versusentropy/wavefolder/panel/.svg2shenzhen-cache/images/B.Cu_g1745.png

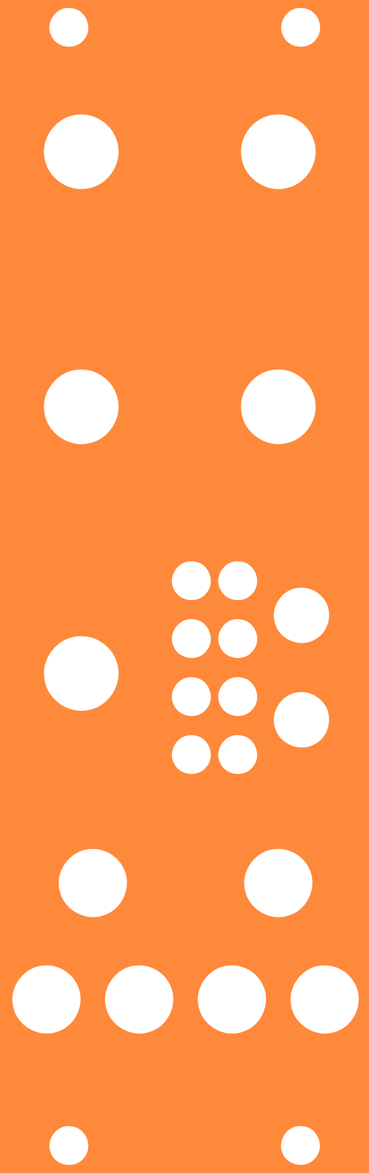
panel/.svg2shenzhen-cache/images/B.Cu_g1745.png
