versusentropy/wavefolder/panel/.svg2shenzhen-cache/images/B.Mask_g1747.png

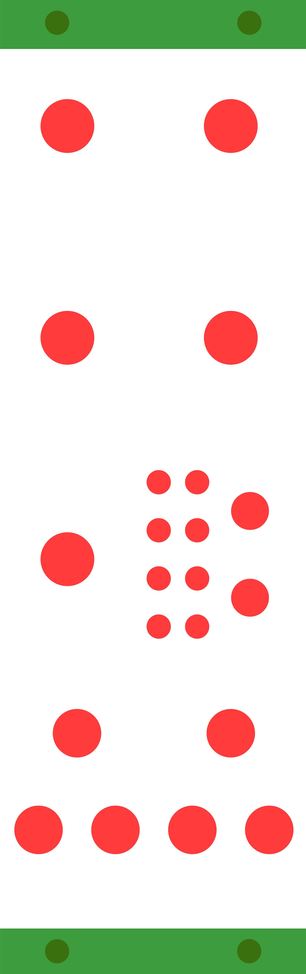
panel/.svg2shenzhen-cache/images/B.Mask_g1747.png
