versusentropy/wavefolder/panel/.svg2shenzhen-cache/images/F.Cu_g1751.png

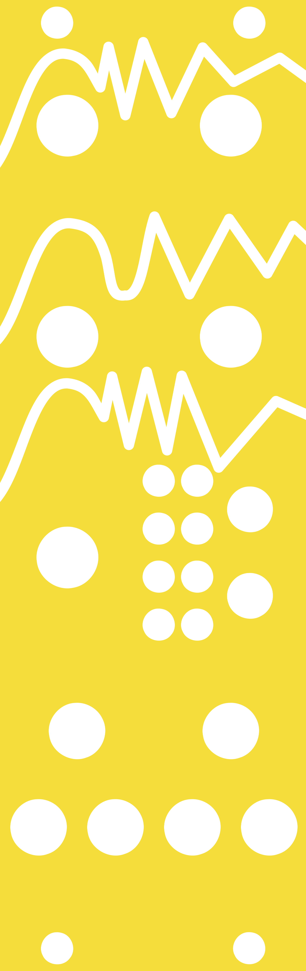
panel/.svg2shenzhen-cache/images/F.Cu_g1751.png
