versusentropy/wavefolder/panel/.svg2shenzhen-cache/images/F.SilkS_g1755.png

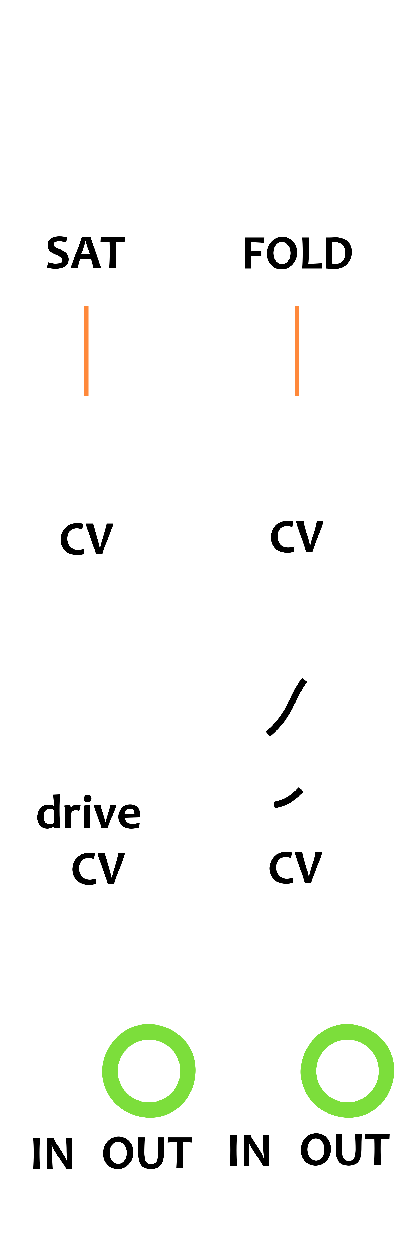
panel/.svg2shenzhen-cache/images/F.SilkS_g1755.png
