versusentropy/wavefolder/wavefolder.kicad_pcb

## KiCad design wavefolder.kicad_pcb (2022-10-06)

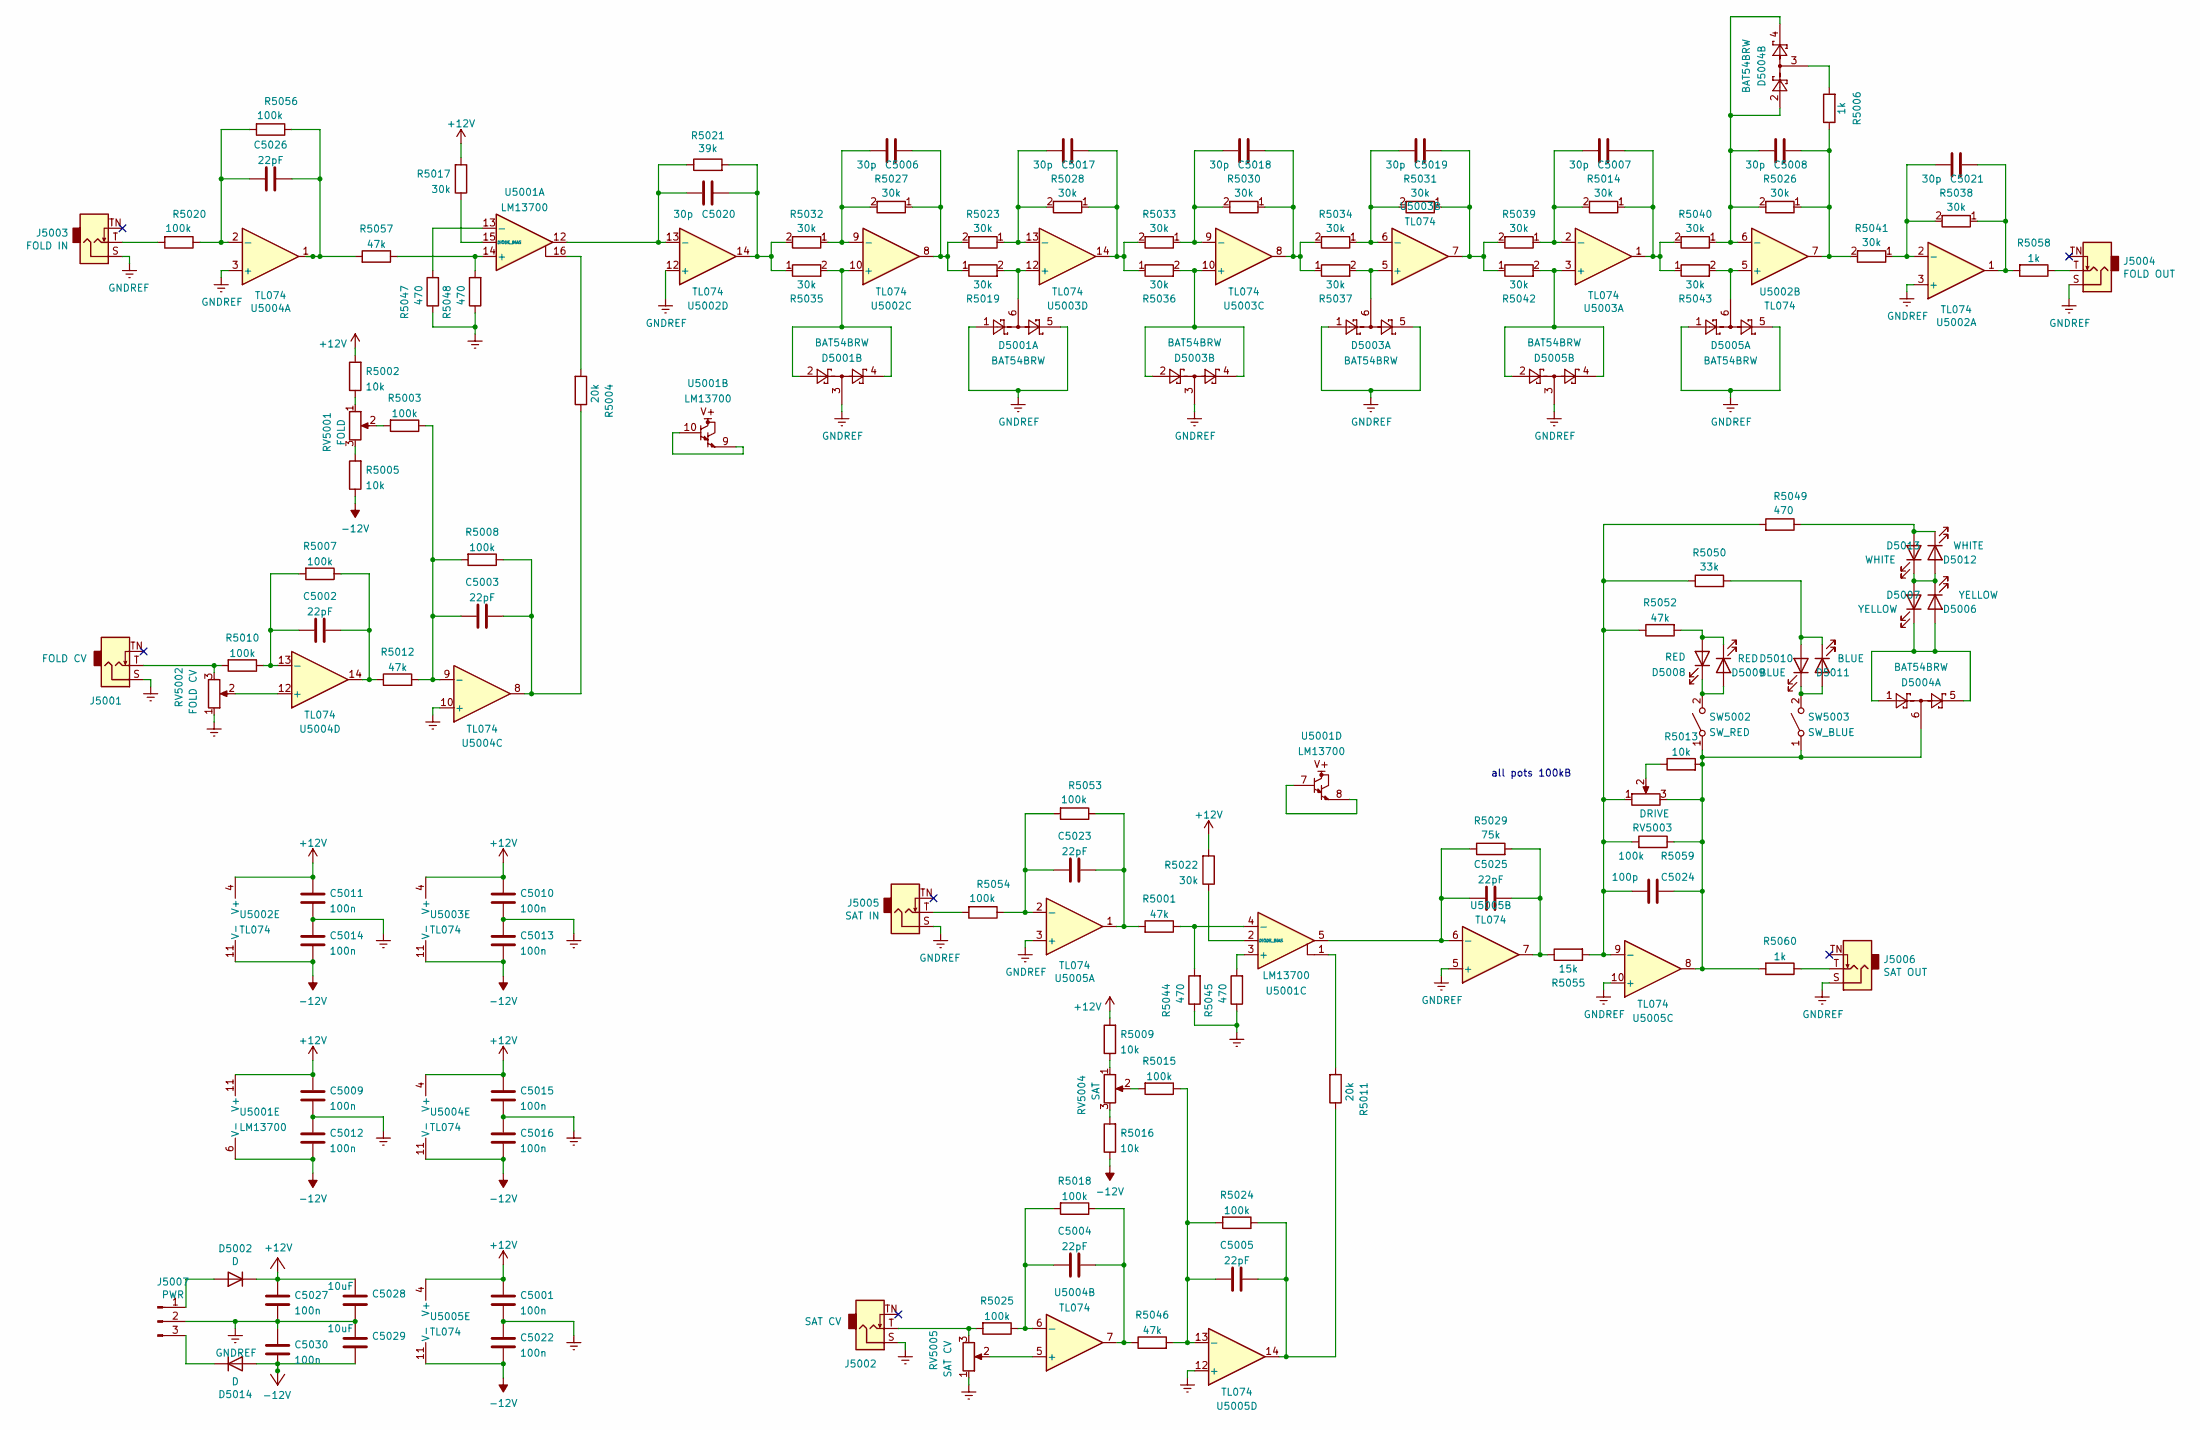
[picture p5: schematic wavefolder.kicad_sch]

Parts:
C5001, C5009, C5010, C5011, C5012, C5013, C5014, C5015, C5016, C5022, C5027, C5030: 100n; C_0402_1005Metric; LCSC C307331
C5002, C5003, C5004, C5005, C5023, C5025, C5026: 22pF; C_0402_1005Metric; LCSC C1555
C5006, C5007, C5008, C5017, C5018, C5019, C5020, C5021: 30p; C_0402_1005Metric; LCSC C1570
C5024: 100p; C_0402_1005Metric; LCSC C1546
C5028, C5029: 10uF; C_0805_2012Metric; LCSC C15850
D5001, D5003, D5004, D5005: BAT54BRW; SOT-363_SC-70-6; LCSC C124897
D5002, D5014: D; D_SOD-123; LCSC C8598
D5006, D5007: YELLOW; LED_D3.0mm
D5008, D5009: RED; LED_D3.0mm
D5010, D5011: BLUE; LED_D3.0mm
D5012, D5013: WHITE; LED_D3.0mm
J5001: FOLD CV; Jack_3.5mm_QingPu_WQP-PJ398SM_Vertical_CircularHolesSMALL
J5002: SAT CV; Jack_3.5mm_QingPu_WQP-PJ398SM_Vertical_CircularHolesSMALL
J5003: FOLD IN; Jack_3.5mm_QingPu_WQP-PJ398SM_Vertical_CircularHolesSMALL
J5004: FOLD OUT; Jack_3.5mm_QingPu_WQP-PJ398SM_Vertical_CircularHolesSMALL
J5005: SAT IN; Jack_3.5mm_QingPu_WQP-PJ398SM_Vertical_CircularHolesSMALL
J5006: SAT OUT; Jack_3.5mm_QingPu_WQP-PJ398SM_Vertical_CircularHolesSMALL
J5007: PWR; eurorac_power-v2
R5001, R5012, R5046, R5052, R5057: 47k; R_0402_1005Metric; LCSC C25792
R5002, R5005, R5009, R5013, R5016: 10k; R_0402_1005Metric; LCSC C25744
R5003, R5007, R5008, R5010, R5015, R5018, R5020, R5024, R5025, R5053, R5054, R5056, R5059: 100k; R_0402_1005Metric; LCSC C25741
R5004, R5011: 20k; R_0603_1608Metric; LCSC C4184
R5006, R5058, R5060: 1k; R_0603_1608Metric; LCSC C21190
R5014, R5017, R5019, R5022, R5023, R5026, R5027, R5028, R5030, R5031, R5032, R5033, R5034, R5035, R5036, R5037, R5038, R5039, R5040, R5041, R5042, R5043: 30k; R_0402_1005Metric; LCSC C141650
R5021: 39k; R_0402_1005Metric; LCSC C25783
R5029: 75k; R_0402_1005Metric; LCSC C25798
R5044, R5045, R5047, R5048, R5049: 470; R_0402_1005Metric; LCSC C25117
R5050: 33k; R_0402_1005Metric; LCSC C141650
R5055: 15k; R_0402_1005Metric; LCSC C25756
RV5001: FOLD; RD901F-ALPHA-POT
RV5002: FOLD CV; RD901F-ALPHA-POT
RV5003: DRIVE; RD901F-ALPHA-POT
RV5004: SAT; RD901F-ALPHA-POT
RV5005: SAT CV; RD901F-ALPHA-POT
SW5002: SW_RED; SW_SPDT_2_5mm
SW5003: SW_BLUE; SW_SPDT_2_5mm
U5001: LM13700; SOIC-16_3.9x9.9mm_P1.27mm; LCSC C174050
U5002, U5003, U5004, U5005: TL074; TSSOP-14_4.4x5mm_P0.65mm; LCSC C96507

Connections:
+12V: C5001.1, C5009.1, C5010.1, C5011.1, C5015.1, C5027.1, C5028.1, D5002.1 (K), R5002.2, R5009.2, R5017.2, R5022.2, U5001.11 (V+), U5002.4 (V+), U5003.4 (V+), U5004.4 (V+), U5005.4 (V+)
-12V: C5012.2, C5013.2, C5014.2, C5016.2, C5022.2, C5029.2, C5030.2, D5014.2 (A), R5005.1, R5016.1, U5001.6 (V-), U5002.11 (V-), U5003.11 (V-), U5004.11 (V-), U5005.11 (V-)
GNDREF: C5001.2, C5009.2, C5010.2, C5011.2, C5012.1, C5013.1, C5014.1, C5015.2, C5016.1, C5022.1, C5027.2, C5028.2, C5029.1, C5030.1, D5001.1, D5001.3, D5001.5, D5003.1, D5003.3, D5003.5, D5005.1, D5005.3, D5005.5, J5001.S, J5002.S, J5003.S, J5004.S, J5005.S, J5006.S, J5007.2, R5044.1, R5045.1, R5047.1, R5048.1, RV5002.1, RV5005.1, U5002.3 (+), U5002.12 (+), U5004.3 (+), U5004.10 (+), U5005.3 (+), U5005.5 (+), U5005.10 (+), U5005.12 (+)
unnamed: C5002.1, R5007.2, R5010.1, U5004.13 (-)
unnamed: C5002.2, R5007.1, R5012.1, U5004.14
unnamed: C5003.1, R5003.1, R5008.2, R5012.2, U5004.9 (-)
unnamed: C5003.2, R5004.1, R5008.1, U5004.8
unnamed: C5004.1, R5018.2, R5025.1, U5004.6 (-)
unnamed: C5004.2, R5018.1, R5046.1, U5004.7
unnamed: C5005.1, R5015.1, R5024.2, R5046.2, U5005.13 (-)
unnamed: C5005.2, R5011.1, R5024.1, U5005.14
unnamed: C5006.1, R5019.1, R5023.2, R5027.1, U5002.8
unnamed: C5006.2, R5027.2, R5032.1, U5002.9 (-)
unnamed: C5007.1, R5014.1, R5040.2, R5043.1, U5003.1
unnamed: C5007.2, R5014.2, R5039.1, U5003.2 (-)
unnamed: C5008.1, R5006.1, R5026.1, R5041.2, U5002.7
unnamed: C5008.2, D5004.2, D5004.4, R5026.2, R5040.1, U5002.6 (-)
unnamed: C5017.1, R5028.1, R5033.2, R5036.1, U5003.14
unnamed: C5017.2, R5023.1, R5028.2, U5003.13 (-)
unnamed: C5018.1, R5030.1, R5034.2, R5037.1, U5003.8
unnamed: C5018.2, R5030.2, R5033.1, U5003.9 (-)
unnamed: C5019.1, R5031.1, R5039.2, R5042.1, U5003.7
unnamed: C5019.2, R5031.2, R5034.1, U5003.6 (-)
unnamed: C5020.1, R5021.2, R5032.2, R5035.1, U5002.14
unnamed: C5020.2, R5021.1, U5001.12, U5002.13 (-)
unnamed: C5021.1, R5038.1, R5058.2, U5002.1
unnamed: C5021.2, R5038.2, R5041.1, U5002.2 (-)
unnamed: C5023.1, R5053.2, R5054.1, U5005.2 (-)
unnamed: C5023.2, R5001.2, R5053.1, U5005.1
unnamed: C5024.1, D5004.6, R5013.2, R5059.1, R5060.2, RV5003.3, SW5002.1 (A), SW5003.1 (A), U5005.8
unnamed: C5024.2, R5049.2, R5050.1, R5052.1, R5055.2, R5059.2, RV5003.1, U5005.9 (-)
unnamed: C5025.1, R5029.1, U5001.5, U5005.6 (-)
unnamed: C5025.2, R5029.2, R5055.1, U5005.7
unnamed: C5026.1, R5020.1, R5056.2, U5004.2 (-)
unnamed: C5026.2, R5056.1, R5057.2, U5004.1
unnamed: D5001.2, D5001.4, R5035.2, U5002.10 (+)
unnamed: D5001.6, R5019.2, U5003.12 (+)
unnamed: D5002.2 (A), J5007.1
unnamed: D5003.2, D5003.4, R5036.2, U5003.10 (+)
unnamed: D5003.6, R5037.2, U5003.5 (+)
unnamed: D5004.1, D5004.5, D5006.2 (A), D5007.1 (K)
unnamed: D5004.3, R5006.2
unnamed: D5005.2, D5005.4, R5042.2, U5003.3 (+)
unnamed: D5005.6, R5043.2, U5002.5 (+)
unnamed: D5006.1 (K), D5007.2 (A), D5012.2 (A), D5013.1 (K)
unnamed: D5008.1 (K), D5009.2 (A), SW5002.2 (B)
unnamed: D5008.2 (A), D5009.1 (K), R5052.2
unnamed: D5010.1 (K), D5011.2 (A), SW5003.2 (B)
unnamed: D5010.2 (A), D5011.1 (K), R5050.2
unnamed: D5012.1 (K), D5013.2 (A), R5049.1
unnamed: D5014.1 (K), J5007.3
unnamed: J5001.T, R5010.2, RV5002.3
unnamed: J5002.T, R5025.2, RV5005.3
unnamed: J5003.T, R5020.2
unnamed: J5004.T, R5058.1
unnamed: J5005.T, R5054.2
unnamed: J5006.T, R5060.1
unnamed: R5001.1, R5044.2, U5001.4 (-)
unnamed: R5002.1, RV5001.1
unnamed: R5003.2, RV5001.2
unnamed: R5004.2, U5001.16
unnamed: R5005.2, RV5001.3
unnamed: R5009.1, RV5004.1
unnamed: R5011.2, U5001.1
unnamed: R5013.1, RV5003.2
unnamed: R5015.2, RV5004.2
unnamed: R5016.2, RV5004.3
unnamed: R5017.1, U5001.15 (DIODE_BIAS)
unnamed: R5022.1, U5001.2 (DIODE_BIAS)
unnamed: R5045.2, U5001.3 (+)
unnamed: R5047.2, U5001.13 (-)
unnamed: R5048.2, R5057.1, U5001.14 (+)
unnamed: RV5002.2, U5004.12 (+)
unnamed: RV5005.2, U5004.5 (+)
unnamed: U5001.7, U5001.8
unnamed: U5001.9, U5001.10

Notes on the sheet:
all pots 100kB

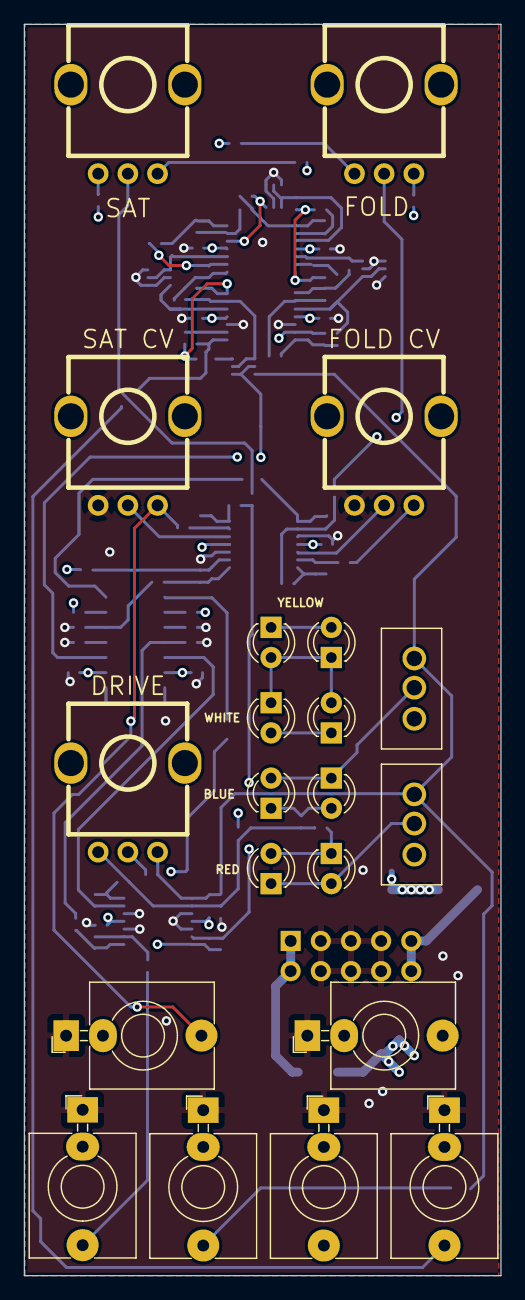
[picture p6: board wavefolder.kicad_pcb from above]

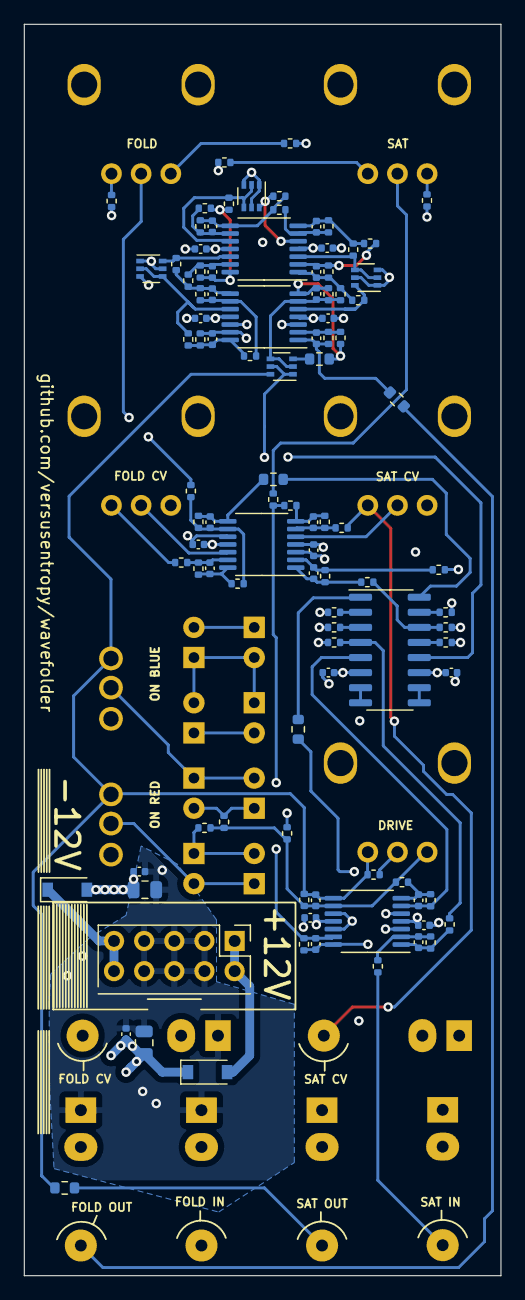
[picture p7: board wavefolder.kicad_pcb from below]

Board: 4 copper layers, 40.1 x 105.4 mm, 122 parts (101 on the bottom side), 76 nets.
