versusentropy/wavefolder/(notices)

Notices in the files:
wavefolder.kicad_pcb:
CC BY-SA-NC 4.0
